xfranerx53/bariyer-alarm/secrets.h

// Wi-Fi ve ESP kullanıcı bilgileri. Alıcı kartına yüklerken alici.ino ile aynı klasörde durmalı.
const char* WIFI_SSID = "SUPERBOX_Wi-Fi_1960";
const char* WIFI_PASS = "DF3FEc5262";
const char* ESP_EMAIL = "esp@bariyer.com";
const char* ESP_PASS  = "mag123";
