xfranerx53/bariyer-alarm/secrets.example.h

// Bu dosya ÖRNEKTİR. Kopyala, adını secrets.h yap, kendi bilgilerini yaz.
// Gerçek secrets.h dosyası GitHub'a YÜKLENMEZ (.gitignore engeller). Sadece bilgisayarında, alici.ino ile aynı klasörde durur.
// Wi-Fi bilgisi ilk açılışta kullanılır; sonra alıcının kurulum modundan (BOOT tuşu 3 sn) telefonla değiştirilebilir.
const char* WIFI_SSID = "WIFI_ADI";
const char* WIFI_PASS = "WIFI_SIFRESI";
const char* ESP_EMAIL = "esp@bariyer.com";
const char* ESP_PASS  = "UZUN_VE_ZOR_BIR_SIFRE";
